awm/rvfs-cpu/hardware/backplane/backplane.kicad_pcb

## KiCad design Modules/MotorDriver/pcb/MotorDriver/MotorDriver.kicad_sch

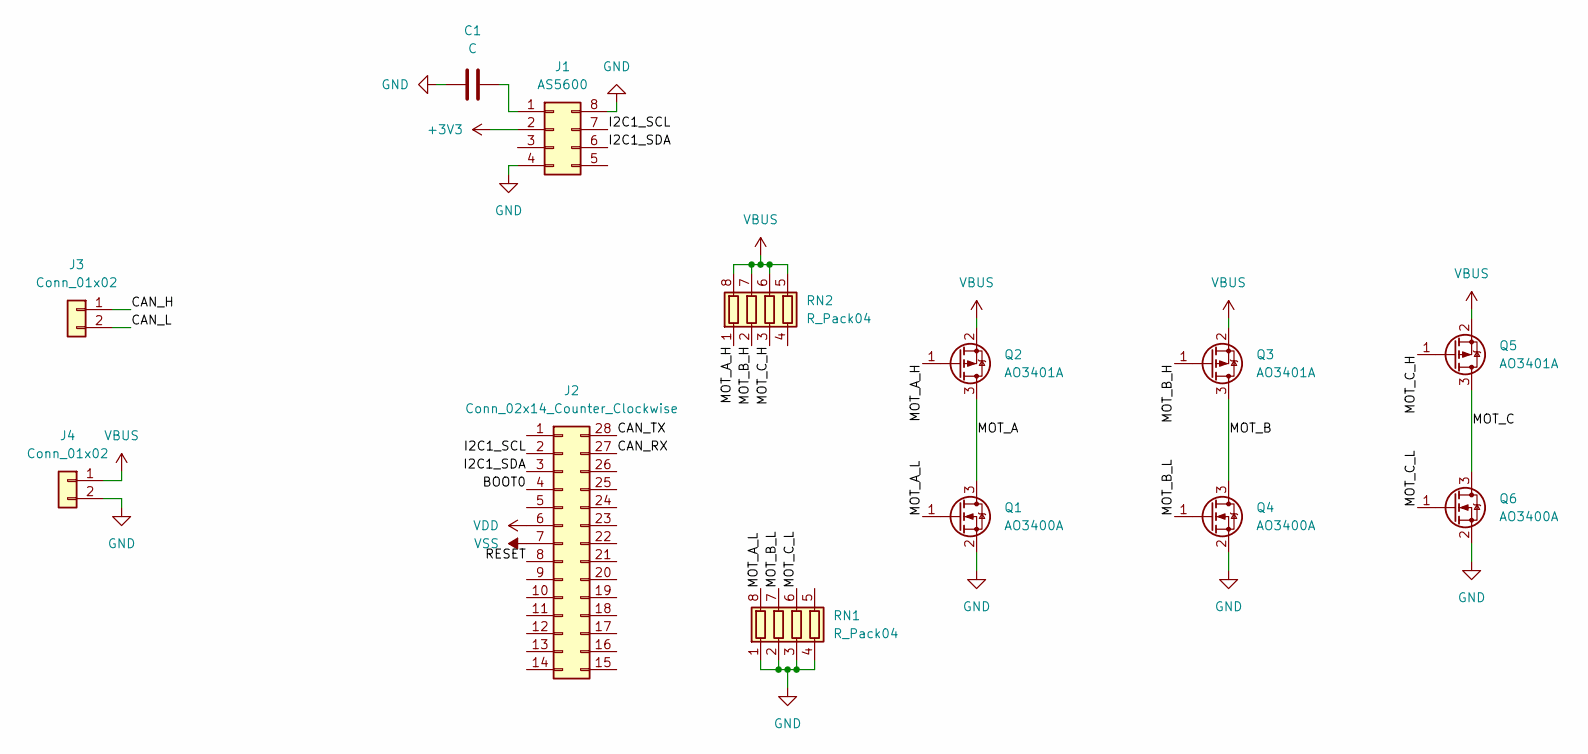
[picture p1: schematic MotorDriver.kicad_sch]

Parts:
C1: C
J1: AS5600
J2: Conn_02x14_Counter_Clockwise
J3, J4: Conn_01x02
Q1, Q4, Q6: AO3400A; SOT-23
Q2, Q3, Q5: AO3401A; SOT-23
RN1, RN2: R_Pack04

Connections:
+3V3: J1.2
BOOT0: J2.4
CAN_H: J3.1
CAN_L: J3.2
CAN_RX: J2.27
CAN_TX: J2.28
GND: C1.1, J1.4, J1.8, J4.2, Q1.2 (S), Q4.2 (S), Q6.2 (S), RN1.1 (R1.1), RN1.2 (R2.1), RN1.3 (R3.1), RN1.4 (R4.1)
I2C1_SCL: J1.7, J2.2
I2C1_SDA: J1.6, J2.3
MOT_A: Q1.3 (D), Q2.3 (D)
MOT_A_H: Q2.1 (G), RN2.1 (R1.1)
MOT_A_L: Q1.1 (G), RN1.8 (R1.2)
MOT_B: Q3.3 (D), Q4.3 (D)
MOT_B_H: Q3.1 (G), RN2.2 (R2.1)
MOT_B_L: Q4.1 (G), RN1.7 (R2.2)
MOT_C: Q5.3 (D), Q6.3 (D)
MOT_C_H: Q5.1 (G), RN2.3 (R3.1)
MOT_C_L: Q6.1 (G), RN1.6 (R3.2)
unnamed: C1.2, J1.1
RESET: J2.8
VBUS: J4.1, Q2.2 (S), Q3.2 (S), Q5.2 (S), RN2.5 (R4.2), RN2.6 (R3.2), RN2.7 (R2.2), RN2.8 (R1.2)
VDD: J2.6
VSS: J2.7
