awm/rvfs-cpu/(commit log)

2024-08-27 feat: Preliminary backplane schematic capture (#3)
    The backplane provides:
    * Power and data connection via USB-C.
    * Power supply for system and for debugger/programmer.
    * Clock generation for CPU and debugger/programmer.
    * Debugger/programmer physical interface.
    * Backplane slot physical interfaces (CPU and peripheral modules).
    [backplane.kicad_pcb, backplane.kicad_sch, clock.kicad_sch, cpu.kicad_sch, cpu_slot.kicad_sch, interface.kicad_sch, mclk_fanout.kicad_sch, peripheral.kicad_sch]
2024-08-27 feat: Re-add peripheral MCLK, add to memory lines (#3)
    Need MCLK to maintain peripheral synchronization. Add missing memory
    access size and latch lines.
    [backplane.kicad_sch, clock.kicad_sch, cpu.kicad_sch, cpu_slot.kicad_sch, interface.kicad_sch, mclk_fanout.kicad_sch, peripheral.kicad_sch, peripherals.kicad_sch]
2024-08-27 feat: Split out ext iface bus and ctrl ports (#3)
    Make them less crowded.
    [bus_ports.kicad_sch, control_port.kicad_sch]
2024-09-05 feat: Assign footprints, add testpoints
    * Verify all footprints are assigned.
    * Create testpoints for key signals.
    * Reorganize component libraries.
    [bus_ports.kicad_sch, clock.kicad_sch, control_port.kicad_sch, cpu_slot.kicad_sch, interface.kicad_sch, mclk_fanout.kicad_sch, peripheral.kicad_sch, power.kicad_sch]
2024-09-11 doc: Document bus architecture
    Additionally, add power requirement.
2024-09-12 feat: Apply bus arch changes to backplane schematic
    [backplane.kicad_sch, bus_ports.kicad_sch, clock.kicad_sch, control_port.kicad_sch, cpu.kicad_sch, cpu_slot.kicad_sch, interface.kicad_sch, mclk_fanout.kicad_sch]
